Nurazkhan/NiroRPI-devboard/README.md

# NiroRPI development Board
Customizing RPI2040 devboard and learning! \

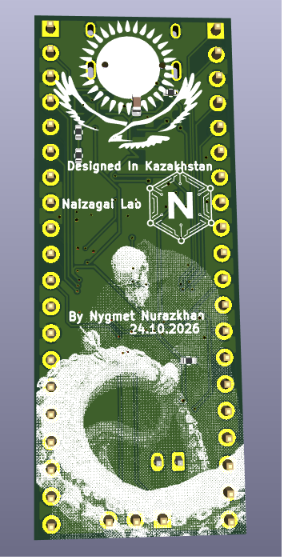
[picture p1: images/3Dfront.png]


---
The NiroRPI board consists of several parts.
First of all it is MCU RPI2040 the brain of the board.
Then you have to gave a memory to the brain, for which QSPI flash memory is responsible for. Another think dev board requires is clock, all crystall oscillator included in the design.
Also, we can't forget about power for which we use USB type C female port.
And we have to decrease it from 5V to 3V3 by linear stabilizator. Apart from that we have to handle noises for which decoupling capacitors where used. Of course you have to add your soul when making project. My piece of soul is in silksreen art.
 
### Unique Feature
- LiPo battery Charging 
The devboard includes capabilities to operate with LiPo Battery. This is achieved by 2 parts.
1. Power Switching Mosfet AO3401A allows to operate devboard on USB C, when connected. And seemlessly switches power supply to batter when USB C removed. This significantly Improves mobility of this devboard.
2. MCP73831 Main Charger IC, which allows to charge the battery while USB C is connected. It also provides information whether battery is currently charging or fully charged on GPIO 25. On GPIO 29 it the voltage divider is set and the percentage of battery can be seen.

## Basic Firmware
Basic firmware is writting in micropython. By default, when connected to device it sends battery connection and percentage charge information over serial.

---
## BOM
| Name | Value | Quantity | Price | Min Buy Price | Link |
|---|---|---|---|---|---|
| 0402 Capacitor | 1uF | 2pc | $0.04/pc |$2.0| [link](https://www.aliexpress.com/item/1005007464553853.html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) |
| 0402 Capacitor | 0.1uF | 10pc | $0.01/pc |$1.24 | [link](https://www.aliexpress.com/item/1005007464553853.html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) |
| 0603 Capacitor | 10uF | 2pc |$0.04|$1.9 | [link](https://www.aliexpress.com/item/1005007464553853.html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) |
| 0402 Capacitor | 33pF | 2pc | $0.0033| $0.66| [link](https://www.aliexpress.com/item/1005004406012464.html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) |
| USB-C Receptacle (14P USB 2.0) | TYPE-C-31-M-12 | 1pc |$0.242 |$2.42 | [link](https://www.aliexpress.com/item/1005005243706874.html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) |
| 1x20 Pin Header 2.54mm Vertical | 20-Pin | 3pc | $0.13|$1.3| [link](https://www.aliexpress.com/item/32852994833.html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) |
| 0402 Resistor | 5.1K | 2pc |$0.0096 | $0.96| [link](https://www.aliexpress.com/item/1005008478030316.html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) |
| 0402 Resistor | 27R | 2pc | $0.0096|$0.96| | [link](https://www.aliexpress.com/item/1005008478030316.html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) |
| 0402 Resistor | 1K | 2pc |$0.0096 | $0.96|| [link](https://www.aliexpress.com/item/1005008478030316.html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) |
| 0402 Resistor | 10K | 1pc | $0.0096| $0.96|| [link](https://www.aliexpress.com/item/1005008478030316.html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) |
| Push Button Switch (SPST-NO Alps SKRK) | SW_Push | 1pc |$0.006 |$3 | [link](https://www.aliexpress.com/ssr/300000512/BundleDealsDutyCovered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) |
| Microcontroller QFN-56 | RP2040 | 1pc |$2.32|$4.64 | [link](https://www.aliexpress.com/item/1005006481247856.html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) |
| LDO Voltage Regulator SOT-23 | MCP1700x-330xxTT | 1pc |$0.235 |$2.35| [link](https://www.aliexpress.com/item/1005010457470744.html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) |
| NOR Flash Memory USON-8 (128Mb) | W25Q128JVS | 1pc |$0.61|$0.61 | [link](https://www.aliexpress.com/item/1005009949894136.html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) |
| Crystal SMD 3225-4Pin | 12MHz | 1pc | $0.3| $2.75| [link](https://www.aliexpress.com/item/1005007282073350.html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) |
|J5|JSTPH 2pin|1pc|$0.5|$2.5|[link](https://www.aliexpress.com/item/4001253349808.html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)|
|U4|MCP73831T|1pc|$0.35|$1.5||
|Q1|AO3401A|1pc|$0.10|$1||
|D1|1N5819|1pc|$0.08|$0.8||
|Mini Hotplate|65W|1pc|$20|$20|[link](https://www.aliexpress.com/item/1005007016135854.html)|

*total: ~$30 (if handsoldered) and $76 if to use JLCPCB assempbly* \
**pinheader needs 3 pc, cause instead of ordering 3pin pinheader, you can break from 20pin pinheaders. Anyways you need to order 5 at least, so its cheaper not to buy seperate 3pinheader one.

---
## Scheme
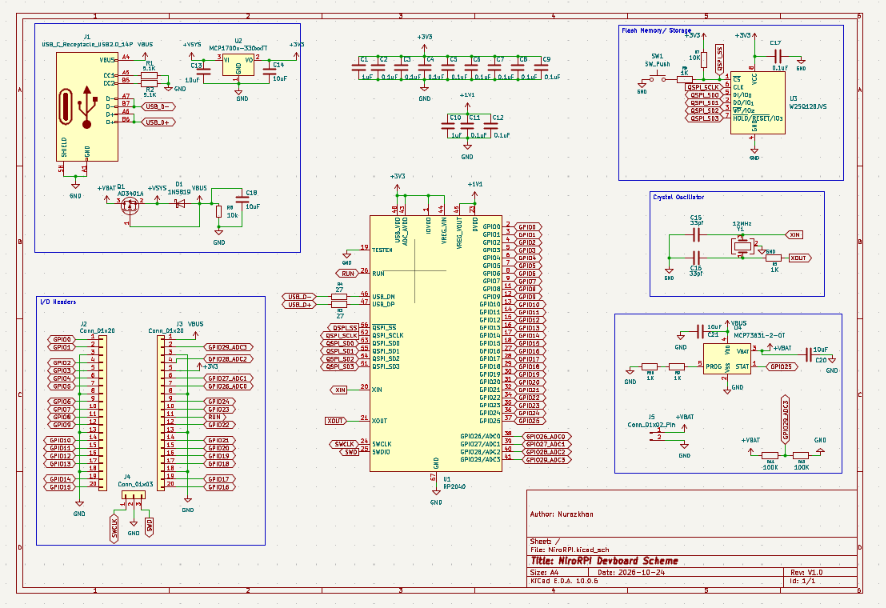
[picture p2: images/scheme.png]

* Pins and connections done using global labels. Scheme seperated in 6 parts.
* Left top corner is TYPE C and Low Voltage regulator.
* Center top is Decoupling capacitors.
* Right top corner is Flash Memory connection scheme.
* Bottom left corner is Pinout for pinheaders
* Center is MCU RPI2040 connection
* and center right is Crystall oscillator connection.

---
## PCB layout

#### Front copper Layer and Back Copper Layer
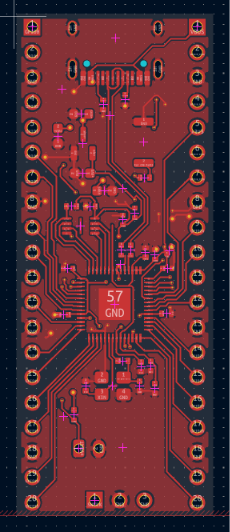
[picture p3: images/PCBfrontCopper.png]
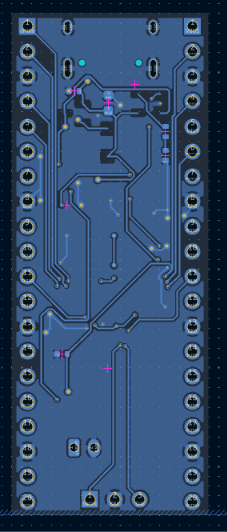
[picture p4: images/PCBbackCopper.png]
 
( SilkScreen hidden )

## front and back with silkscreen
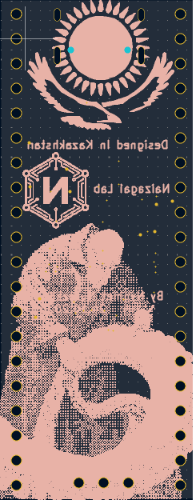
[picture p5: images/image-4.png]
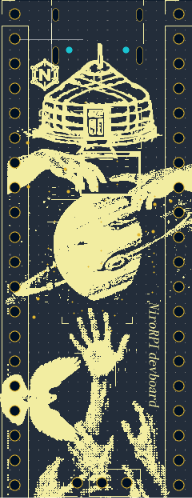
[picture p6: images/image-5.png]
 

## 3D view front and back
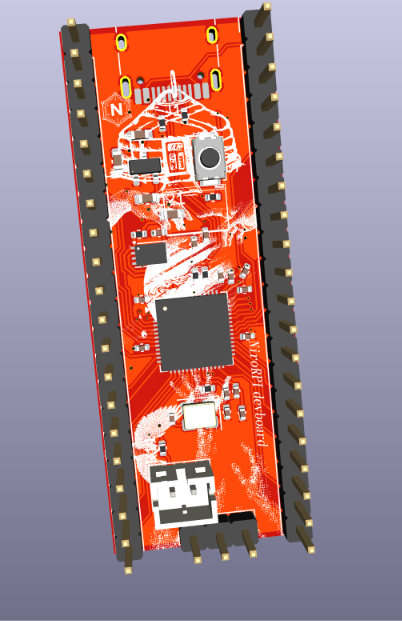
[picture p7: images/3Dback.png]



# Thank you, hack club!
