Nurazkhan/NiroRPI-devboard/images/Charger.png

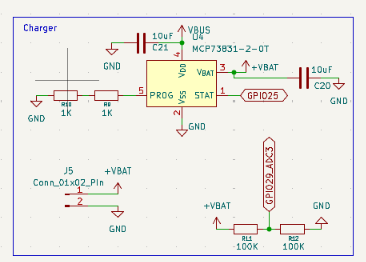
images/Charger.png
