Nurazkhan/NiroRPI-devboard/images/DRC.png

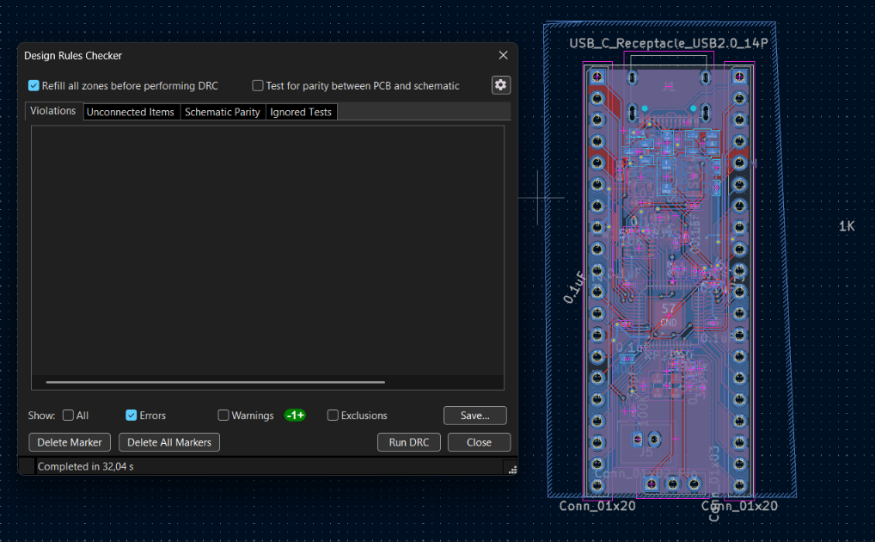
images/DRC.png
