Nurazkhan/NiroRPI-devboard/images/ERC.png

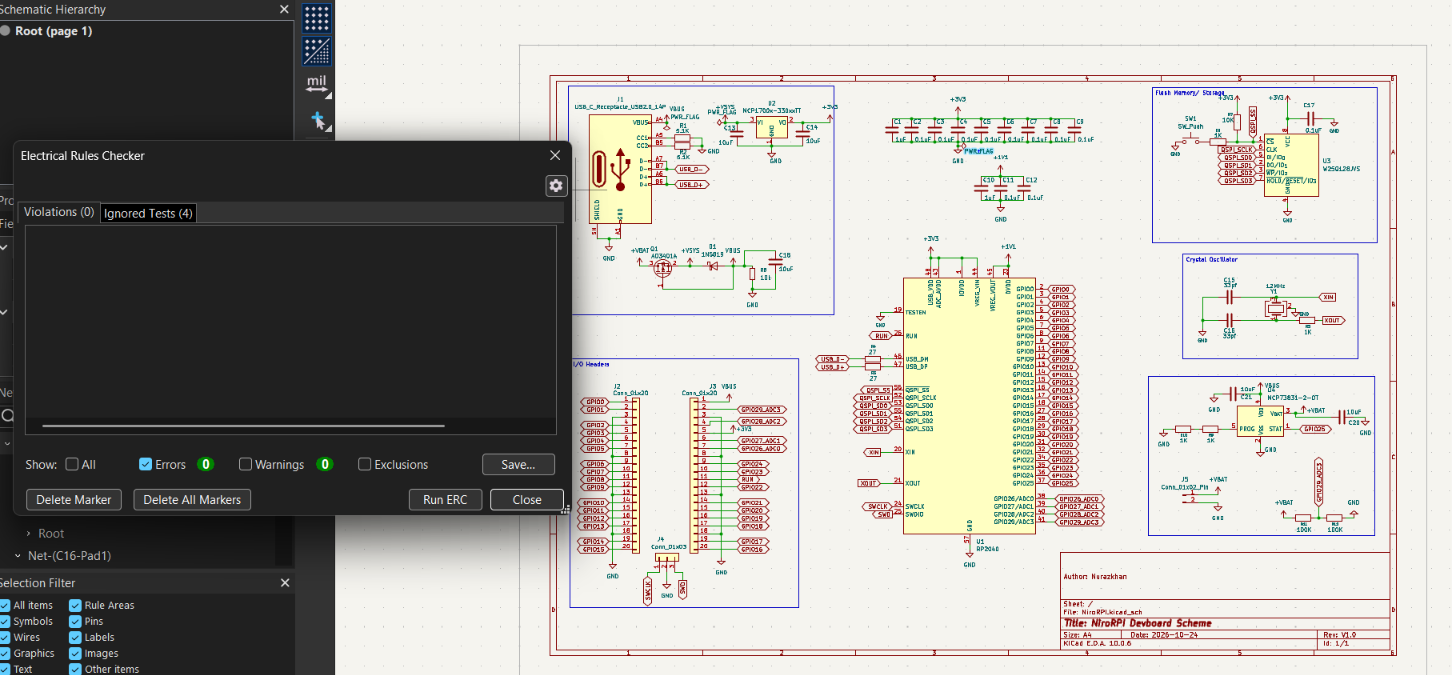
images/ERC.png
