Nurazkhan/NiroRPI-devboard/images/Power.png

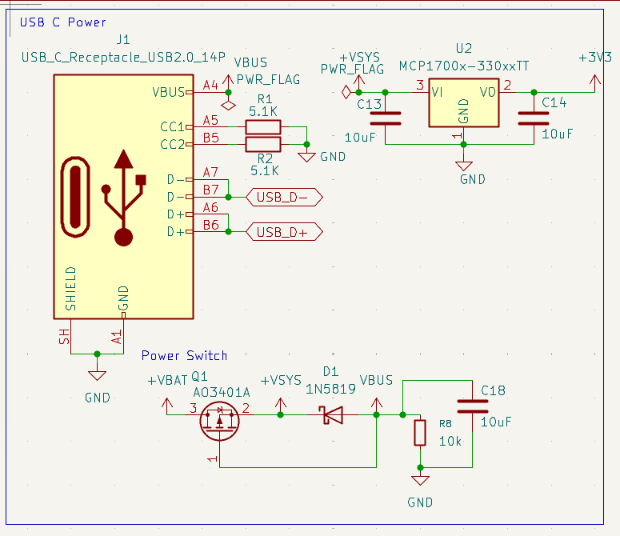
images/Power.png
