Nurazkhan/NiroRPI-devboard/PCB/art/159758893-portable-circle-urta-covered-with-skin-or-felt-isolated-on-white-backdrop-freehand-outline-black.jpg

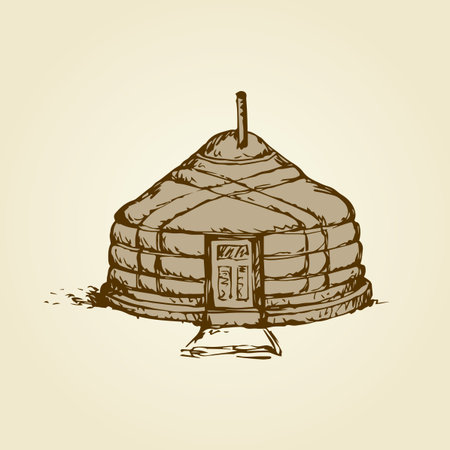
PCB/art/159758893-portable-circle-urta-covered-with-skin-or-felt-isolated-on-white-backdrop-freehand-outline-black.jpg
