Nurazkhan/NiroRPI-devboard/PCB/art/images (1).png

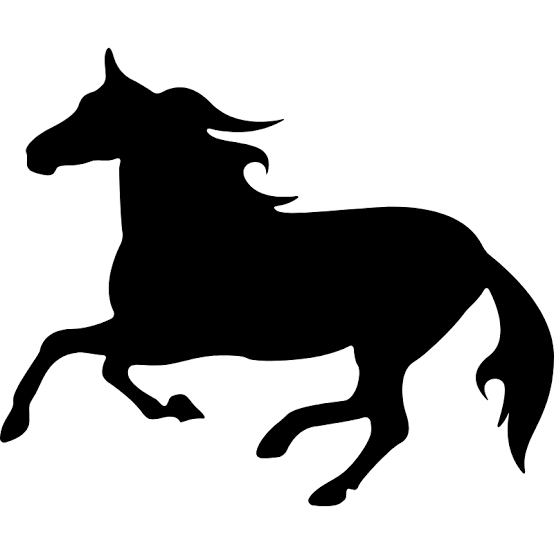
PCB/art/images (1).png
