Nurazkhan/NiroRPI-devboard/PCB/art/images (2).png

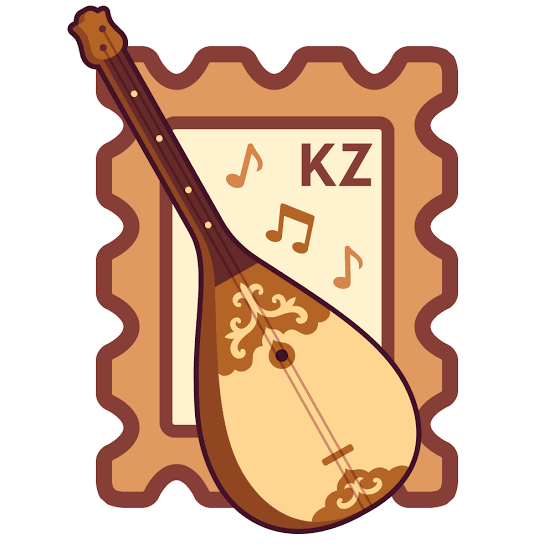
PCB/art/images (2).png
