Nurazkhan/NiroRPI-devboard/BOM.csv

Name | Value | Quantity | Price | Min Buy Price | Link
0402 Capacitor | 1uF | 2pc | $0.04/pc | $2.0 | https://www.aliexpress.com/item/1005007464553853.html?curPageLogUid=Z1IctUtDfu5q
0402 Capacitor | 0.1uF | 10pc | $0.01/pc | $1.24 | https://www.aliexpress.com/item/1005007464553853.html?curPageLogUid=Z1IctUtDfu5q
0603 Capacitor | 10uF | 2pc | $0.04 | $1.9 | https://www.aliexpress.com/item/1005007464553853.html?curPageLogUid=COmJyo83HHxI
0402 Capacitor | 33pF | 2pc | $0.0033 | $0.66 | https://www.aliexpress.com/item/1005004406012464.html?curPageLogUid=WZNt2OROy7tG
USB-C Receptacle (14P USB 2.0) | TYPE-C-31-M-12 | 1pc | $0.242 | $2.42 | https://www.aliexpress.com/item/1005005243706874.html?curPageLogUid=PttTDNerzeWs
1x20 Pin Header 2.54mm Vertical | 20-Pin | 3pc | $0.13 | $1.3 | https://www.aliexpress.com/item/32852994833.html?curPageLogUid=S8hGZYq8zqir
0402 Resistor | 5.1K | 2pc | $0.0096 | $0.96 | https://www.aliexpress.com/item/1005008478030316.html?curPageLogUid=txJdVtTcEzpI
0402 Resistor | 27R | 2pc | $0.0096 | $0.96 | https://www.aliexpress.com/item/1005008478030316.html?curPageLogUid=txJdVtTcEzpI
0402 Resistor | 1K | 2pc | $0.0096 | $0.96 | https://www.aliexpress.com/item/1005008478030316.html?curPageLogUid=txJdVtTcEzpI
0402 Resistor | 10K | 1pc | $0.0096 | $0.96 | https://www.aliexpress.com/item/1005008478030316.html?curPageLogUid=txJdVtTcEzpI
Push Button Switch (SPST-NO Alps SKRK) | SW_Push | 1pc | $0.006 | $3 | https://www.aliexpress.com/ssr/300000512/BundleDealsDutyCovered?businessCode=guide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
Microcontroller QFN-56 | RP2040 | 1pc | $2.32 | $4.64 | https://www.aliexpress.com/item/1005006481247856.html?curPageLogUid=oizp8OHJRp5m
LDO Voltage Regulator SOT-23 | MCP1700x-330xxTT | 1pc | $0.235 | $2.35 | https://www.aliexpress.com/item/1005010457470744.html?curPageLogUid=GqBMlJZrs2cj
NOR Flash Memory USON-8 (128Mb) | W25Q128JVS | 1pc | $0.61 | $0.61 | https://www.aliexpress.com/item/1005009949894136.html?curPageLogUid=moexlDes1oED
Crystal SMD 3225-4Pin | 12MHz | 1pc | $0.3 | $2.75 | https://www.aliexpress.com/item/1005007282073350.html?curPageLogUid=GtFPoNpVzfLV
Mini Hot plate | '65w' | '1pc' | $20 | "$20" | "https://www.aliexpress.com/item/1005007016135854.html?curPageLogUid=aHPxeodvrJTx"
