Nurazkhan/NiroRPI-devboard/(commit log)

2026-10-24 pcb design finished
    [NiroRPI-B_Cu.gbr, NiroRPI-B_Mask.gbr, NiroRPI-B_Paste.gbr, NiroRPI-B_Silkscreen.gbr, NiroRPI-Edge_Cuts.gbr, NiroRPI-F_Cu.gbr, NiroRPI-F_Mask.gbr, NiroRPI-F_Paste.gbr]
2026-10-24 readme and BOM
    [BOM.csv]
2026-11-06 Battery Charger readme + bom
2026-11-06 readme fix front image
    [main.py]
2026-11-11 patch: uplaoded correct kicad files
    [NiroRPI-B_Cu.gbr, NiroRPI-B_Mask.gbr, NiroRPI-B_Paste.gbr, NiroRPI-B_Silkscreen.gbr, NiroRPI-Edge_Cuts.gbr, NiroRPI-F_Cu.gbr, NiroRPI-F_Mask.gbr, NiroRPI-F_Paste.gbr]
2026-11-11 bom hot plate add
    [BOM.csv]
